homebrew8088/CH376-ISA/README.md

# CH376 ISA
 CH376 on ISA card with BIOS ext
