homebrew8088/CH376-ISA/Kicad/CH376S ISA.kicad_pcb

## KiCad design Kicad/CH376S ISA.kicad_pcb (2023-07-27)

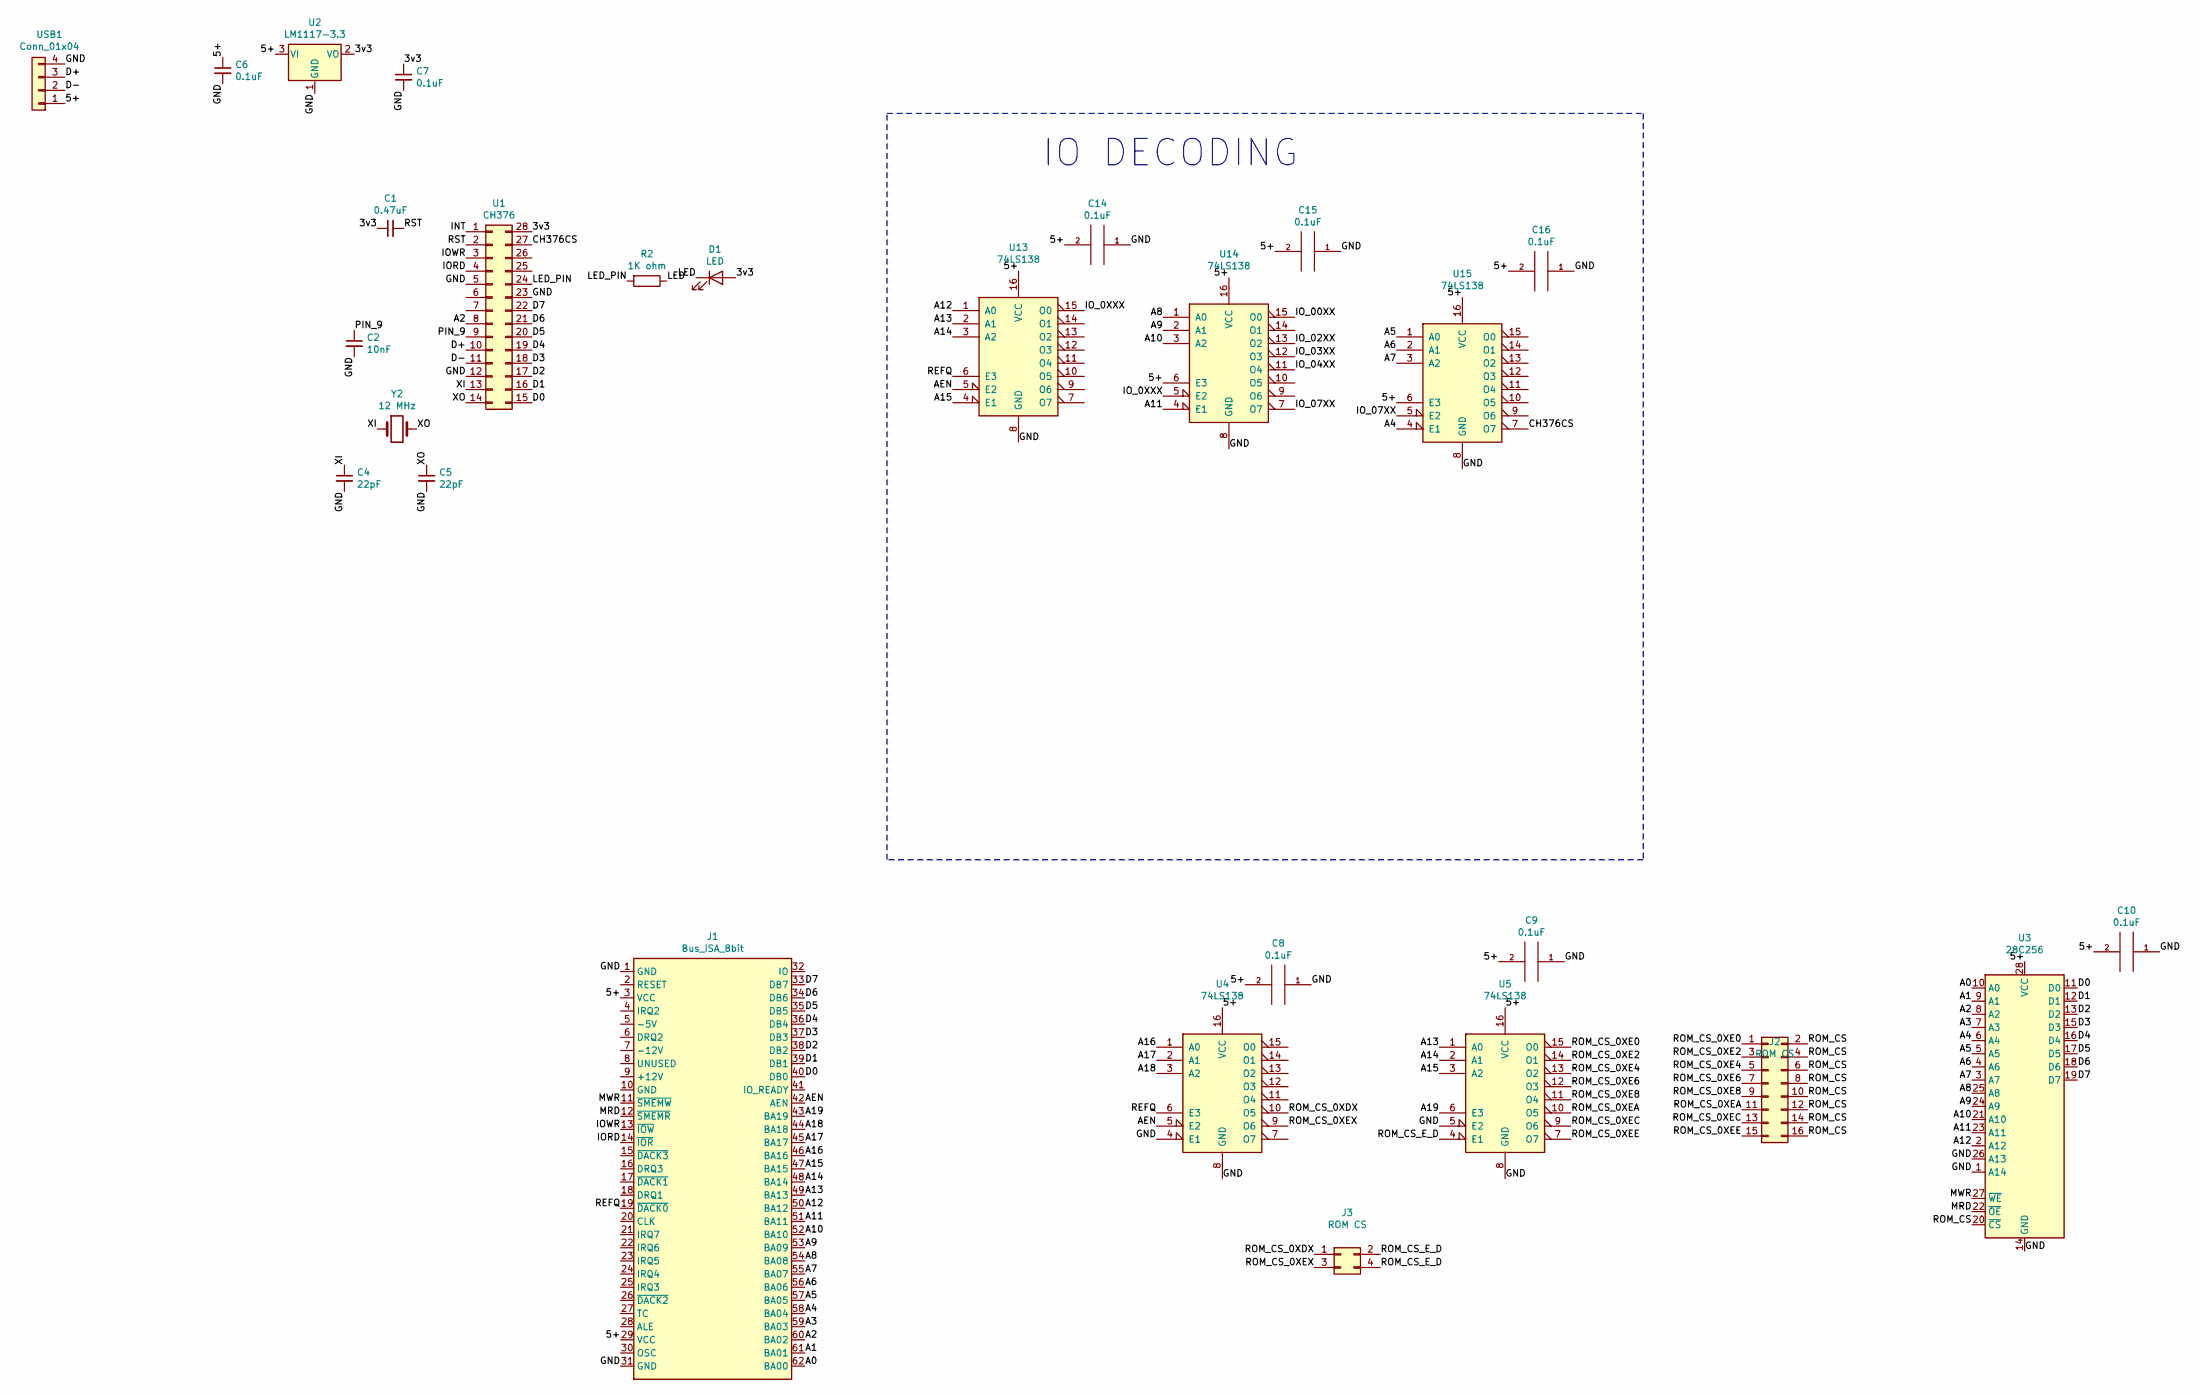
[picture p1: schematic CH376S ISA.sch]

Parts:
C1: 0.47uF; C_Disc_D4.3mm_W1.9mm_P5.00mm
C2: 10nF; C_Disc_D4.3mm_W1.9mm_P5.00mm
C4, C5: 22pF; C_Disc_D4.3mm_W1.9mm_P5.00mm
C6, C7, C8, C9, C10, C14, C15, C16: 0.1uF; C_Disc_D4.3mm_W1.9mm_P5.00mm
D1: LED; LED_D3.0mm
J1: Bus_ISA_8bit; BUS_8_BIT
J2: ROM CS; PinHeader_2x08_P2.54mm_Vertical
J3: ROM CS; PinHeader_2x02_P2.54mm_Vertical
R2: 1K ohm; R_Axial_DIN0207_L6.3mm_D2.5mm_P10.16mm_Horizontal
U1: CH376; SOIC-28W_7.5x17.9mm_P1.27mm
U2: LM1117-3.3; TO-220-3_Horizontal_TabDown
U3: 28C256; DIP-28_W15.24mm
U4, U5, U13, U14, U15: 74LS138; DIP-16_W7.62mm
USB1: Conn_01x04; USB_A_CONNFLY_DS1095-WNR0
Y2: 12 MHz; Crystal_HC18-U_Vertical

Connections:
/3v3: C1.1, C7.1, D1.2 (A), U1.28, U2.2 (VO)
/5+: C6.1, C8.2, C9.2, C10.2, C14.2, C15.2, C16.2, J1.3 (VCC), J1.29 (VCC), U2.3 (VI), U3.28 (VCC), U4.16 (VCC), U5.16 (VCC), U13.16 (VCC), U14.6 (E3), U14.16 (VCC), U15.6 (E3), U15.16 (VCC), USB1.1
/A0: J1.62 (BA00), U3.10 (A0)
/A1: J1.61 (BA01), U3.9 (A1)
/A2: J1.60 (BA02), U1.8, U3.8 (A2)
/A3: J1.59 (BA03), U3.7 (A3)
/A4: J1.58 (BA04), U3.6 (A4), U15.4 (E1)
/A5: J1.57 (BA05), U3.5 (A5), U15.1 (A0)
/A6: J1.56 (BA06), U3.4 (A6), U15.2 (A1)
/A7: J1.55 (BA07), U3.3 (A7), U15.3 (A2)
/A8: J1.54 (BA08), U3.25 (A8), U14.1 (A0)
/A9: J1.53 (BA09), U3.24 (A9), U14.2 (A1)
/A10: J1.52 (BA10), U3.21 (A10), U14.3 (A2)
/A11: J1.51 (BA11), U3.23 (A11), U14.4 (E1)
/A12: J1.50 (BA12), U3.2 (A12), U13.1 (A0)
/A13: J1.49 (BA13), U5.1 (A0), U13.2 (A1)
/A14: J1.48 (BA14), U5.2 (A1), U13.3 (A2)
/A15: J1.47 (BA15), U5.3 (A2), U13.4 (E1)
/A16: J1.46 (BA16), U4.1 (A0)
/A17: J1.45 (BA17), U4.2 (A1)
/A18: J1.44 (BA18), U4.3 (A2)
/A19: J1.43 (BA19), U5.6 (E3)
/AEN: J1.42 (AEN), U4.5 (E2), U13.5 (E2)
/CH376CS: U1.27, U15.7 (O7)
/D0: J1.40 (DB0), U1.15, U3.11 (D0)
/D1: J1.39 (DB1), U1.16, U3.12 (D1)
/D2: J1.38 (DB2), U1.17, U3.13 (D2)
/D3: J1.37 (DB3), U1.18, U3.15 (D3)
/D4: J1.36 (DB4), U1.19, U3.16 (D4)
/D5: J1.35 (DB5), U1.20, U3.17 (D5)
/D6: J1.34 (DB6), U1.21, U3.18 (D6)
/D7: J1.33 (DB7), U1.22, U3.19 (D7)
/D+: U1.10, USB1.3
/D-: U1.11, USB1.2
/GND: C2.2, C4.2, C5.2, C6.2, C7.2, C8.1, C9.1, C10.1, C14.1, C15.1, C16.1, J1.1 (GND), J1.31 (GND), U1.5, U1.12, U1.23, U2.1 (GND), U3.1 (A14), U3.14 (GND), U3.26 (A13), U4.4 (E1), U4.8 (GND), U5.5 (E2), U5.8 (GND), U13.8 (GND), U14.8 (GND), U15.8 (GND), USB1.4
/INT: U1.1
/IORD: J1.14 (~IOR), U1.4
/IOWR: J1.13 (~IOW), U1.3
/IO_00XX: U14.15 (O0)
/IO_0XXX: U13.15 (O0), U14.5 (E2)
/IO_02XX: U14.13 (O2)
/IO_03XX: U14.12 (O3)
/IO_04XX: U14.11 (O4)
/IO_07XX: U14.7 (O7), U15.5 (E2)
/LED: D1.1 (K), R2.1
/LED_PIN: R2.2, U1.24
/MRD: J1.12 (~SMEMR), U3.22 (~OE)
/MWR: J1.11 (~SMEMW), U3.27 (~WE)
/PIN_9: C2.1, U1.9
/REFQ: J1.19 (~DACK0), U4.6 (E3), U13.6 (E3)
/ROM_CS: J2.2, J2.4, J2.6, J2.8, J2.10, J2.12, J2.14, J2.16, U3.20 (~CS)
/ROM_CS_0XDX: J3.1, U4.10 (O5)
/ROM_CS_0XE0: J2.1, U5.15 (O0)
/ROM_CS_0XE2: J2.3, U5.14 (O1)
/ROM_CS_0XE4: J2.5, U5.13 (O2)
/ROM_CS_0XE6: J2.7, U5.12 (O3)
/ROM_CS_0XE8: J2.9, U5.11 (O4)
/ROM_CS_0XEA: J2.11, U5.10 (O5)
/ROM_CS_0XEC: J2.13, U5.9 (O6)
/ROM_CS_0XEE: J2.15, U5.7 (O7)
/ROM_CS_0XEX: J3.3, U4.9 (O6)
/ROM_CS_E_D: J3.2, J3.4, U5.4 (E1)
/RST: C1.2, U1.2
/XI: C4.1, U1.13, Y2.1
/XO: C5.1, U1.14, Y2.2

Notes on the sheet:
IO DECODING

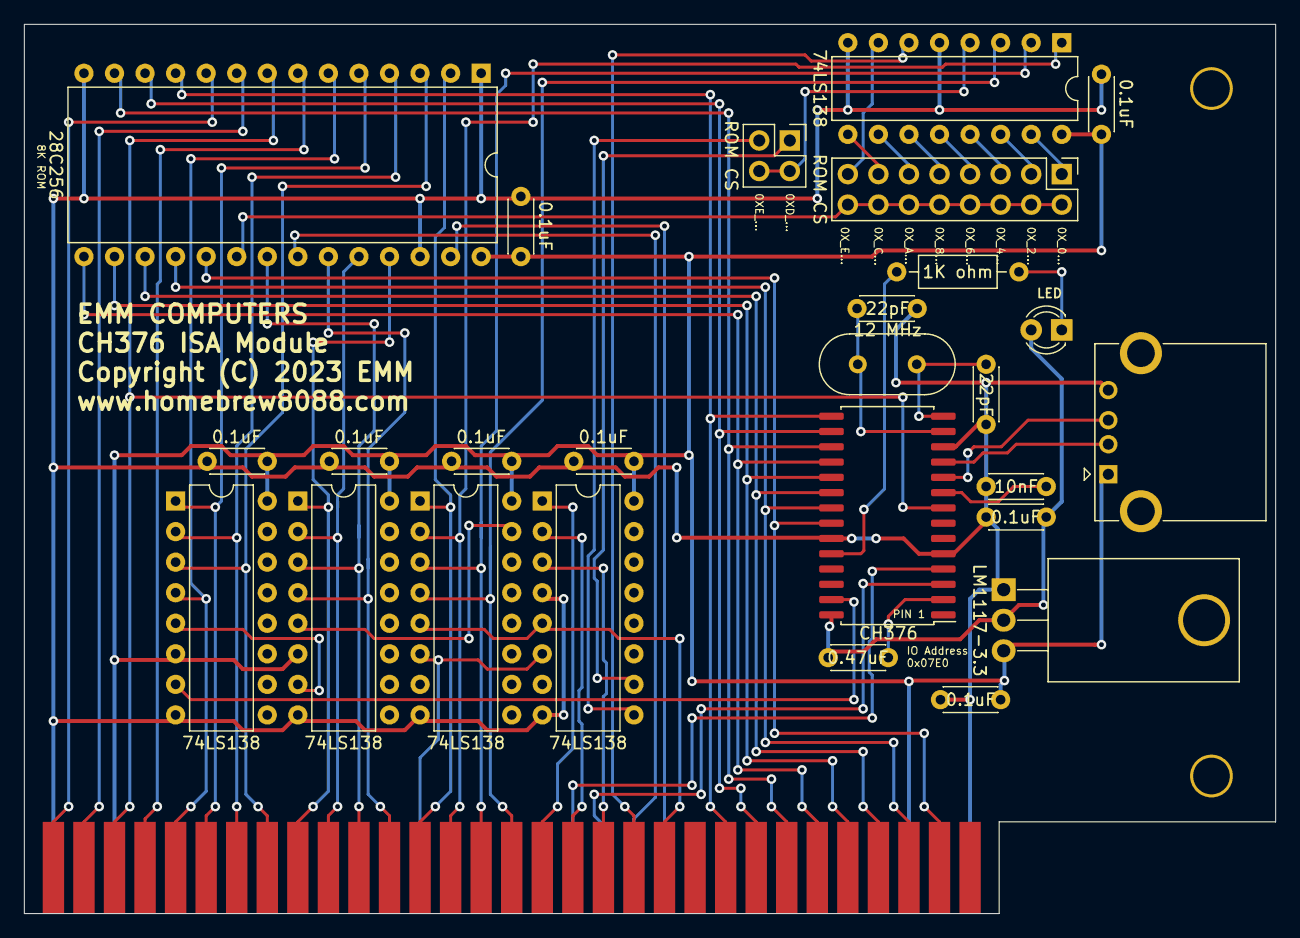
[picture p2: board CH376S ISA.kicad_pcb from above]

Board: 2 copper layers, 104.0 x 73.9 mm, 29 parts (0 on the bottom side), 60 nets.

Other parts of the board:
R: L; Large_Via
R#2: L; Large_Via
