homebrew8088/CH376-ISA/(commit log)

2023-04-09 initial post
    [CH376S ISA.kicad_pcb, CH376S ISA.sch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]
2023-05-08 first draft done
    [CH376S ISA-B_Cu.gbr, CH376S ISA-B_Mask.gbr, CH376S ISA-B_Paste.gbr, CH376S ISA-B_SilkS.gbr, CH376S ISA-Edge_Cuts.gbr, CH376S ISA-F_Cu.gbr, CH376S ISA-F_Mask.gbr, CH376S ISA-F_Paste.gbr]
2023-05-08 Widen trace
    [CH376S ISA-B_Cu.gbr, CH376S ISA-B_Mask.gbr, CH376S ISA-B_Paste.gbr, CH376S ISA-B_SilkS.gbr, CH376S ISA-Edge_Cuts.gbr, CH376S ISA-F_Cu.gbr, CH376S ISA-F_Mask.gbr, CH376S ISA-F_Paste.gbr]
2023-06-13 Changed IO address to 0x07E0
    [CH376S ISA-B_Cu.gbr, CH376S ISA-B_Mask.gbr, CH376S ISA-B_Paste.gbr, CH376S ISA-B_SilkS.gbr, CH376S ISA-Edge_Cuts.gbr, CH376S ISA-F_Cu.gbr, CH376S ISA-F_Mask.gbr, CH376S ISA-F_Paste.gbr]
