homebrew8088/CH376-ISA/(notices)

Notices in the files:
Kicad/CH376S ISA.kicad_pcb:
Copyright (C) 2023 EMM
